weblionx/disaster-radio/hardware/board_v3/lora_nodemcu.kicad_pcb

## KiCad design hardware/board_v3/lora_nodemcu.kicad_pcb (2018-08-20)

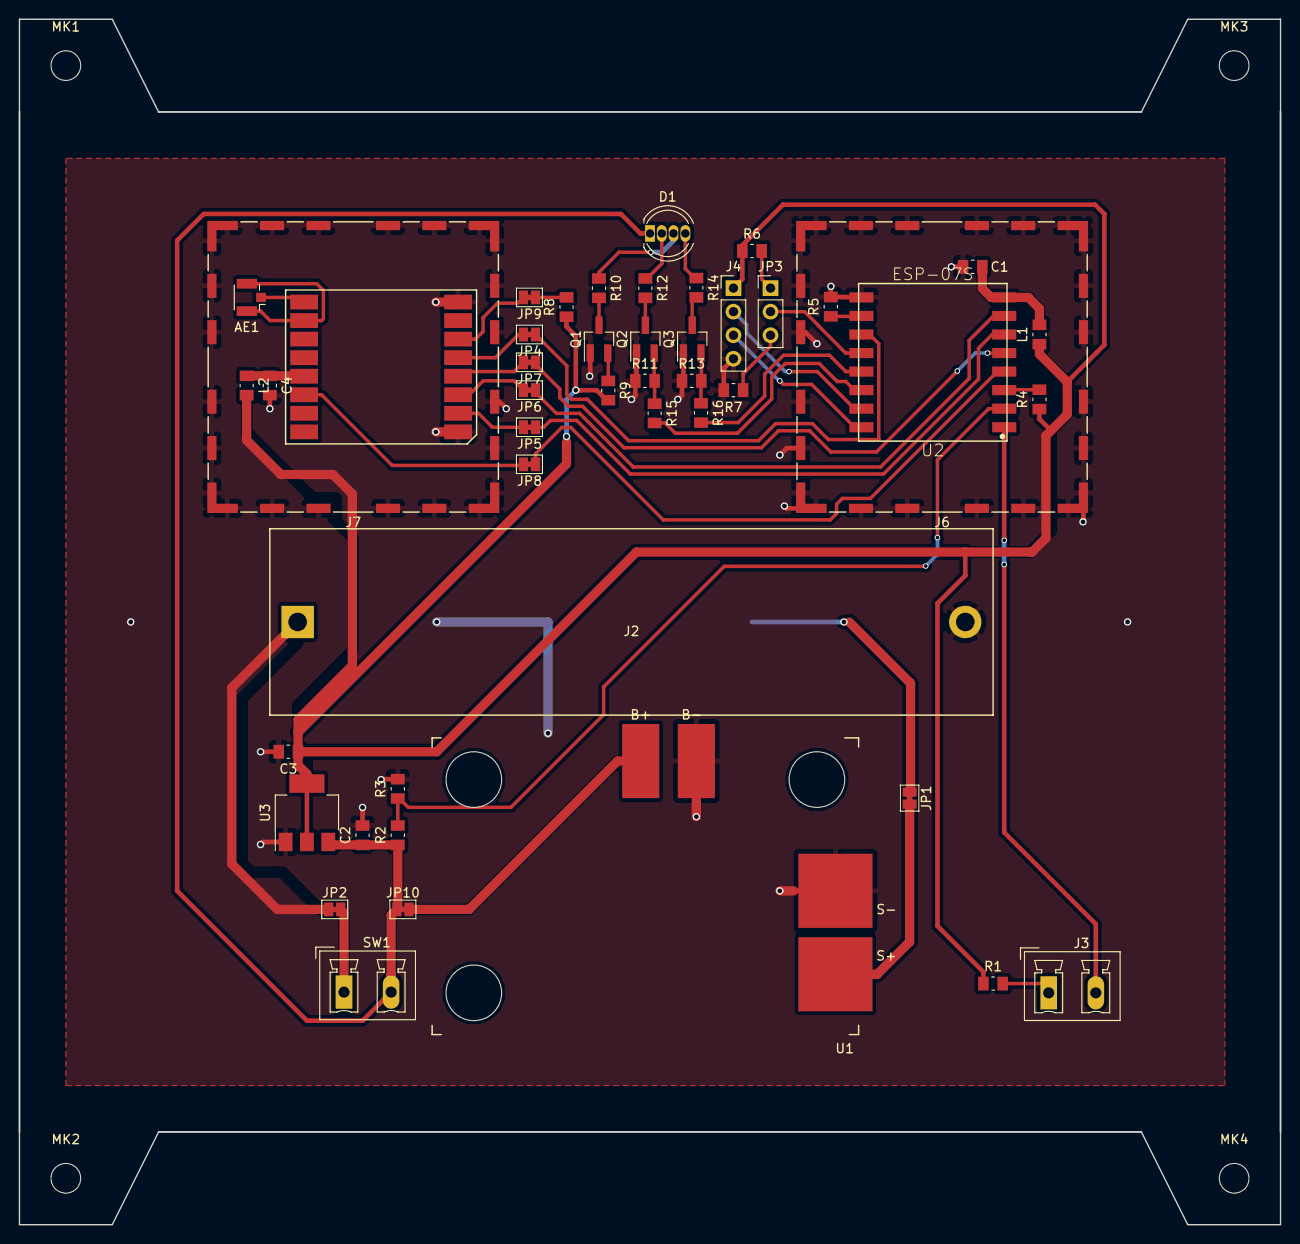
[picture p1: board lora_nodemcu.kicad_pcb from above]

Board: 2 copper layers, 136.0 x 130.0 mm, 52 parts (1 on the bottom side), 45 nets.

Parts:
AE1: RFM95_Antenna; U.FL_Hirose_U.FL-R-SMT-1_Vertical
C1, C4: 0.1uF; C_0805_2012Metric_Pad1.15x1.50mm_HandSolder
C2, C3: 10uF; C_0805_2012Metric_Pad1.15x1.50mm_HandSolder
D1: LED_ARGB; LED_D5.0mm-4
J1: Solar Panel; solar_panel_conn
J2: LiPo 18650; BatteryHolder_MPD_BH-18650-PC2
J3: RESET_BUTTON; PhoenixContact_MCV_1,5_2-G-5.08_1x02_P5.08mm_Vertical
J4: ESP_PRGM; PinHeader_1x04_P2.54mm_Vertical
J6: RF_Shield_ESP-07S; Wuerth_36103305_30x30mm
J7: RF_Shield_RFM95; Wuerth_36103305_30x30mm
JP1: SOLAR_TP; SolderJumper-2_P1.3mm_Bridged_Pad1.0x1.5mm
JP2: LiPo_TP; SolderJumper-2_P1.3mm_Bridged_Pad1.0x1.5mm
JP3: PRGM_SELECT; PinHeader_1x03_P2.54mm_Vertical
JP4: CS; SolderJumper-2_P1.3mm_Bridged_Pad1.0x1.5mm
JP5: MISO; SolderJumper-2_P1.3mm_Bridged_Pad1.0x1.5mm
JP6: MOSI; SolderJumper-2_P1.3mm_Bridged_Pad1.0x1.5mm
JP7: CLK; SolderJumper-2_P1.3mm_Bridged_Pad1.0x1.5mm
JP8: D1; SolderJumper-2_P1.3mm_Bridged_Pad1.0x1.5mm
JP9: RST; SolderJumper-2_P1.3mm_Bridged_Pad1.0x1.5mm
JP10: MPPT_TP; SolderJumper-2_P1.3mm_Bridged_Pad1.0x1.5mm
L1, L2: JUMPER; L_0805_2012Metric_Pad1.15x1.50mm_HandSolder
MK1, MK2, MK3, MK4: Mounting_Hole; MountingHole_3.2mm_M3
Q1, Q2, Q3: 2N3904; SOT-23_Handsoldering
R1, R3, R4, R5, R6, R7, R8, R9, R11, R13, R15, R16: 10K; R_0805_2012Metric_Pad1.15x1.50mm_HandSolder
R2: 47K; R_0805_2012Metric_Pad1.15x1.50mm_HandSolder
R10: 1K; R_0805_2012Metric_Pad1.15x1.50mm_HandSolder
R12: 470; R_0805_2012Metric_Pad1.15x1.50mm_HandSolder
R14: 330; R_0805_2012Metric_Pad1.15x1.50mm_HandSolder
SW1: SW_SPST; PhoenixContact_MCV_1,5_2-G-5.08_1x02_P5.08mm_Vertical
U1: CN3791_module
U2: ESP-07S
U3: LM1117-3.3; SOT-223-3_TabPin2
U4: RFM95

Connections:
+3V3: C3.1, J4.1, L1.1, L2.2, R1.1, R4.1, R6.1, R8.1, R9.2, U3.2
+BATT: C2.1, D1.1, JP10.1, R2.1, SW1.2, U3.3
/3V3_ESP: C1.1, L1.2, U2.8
/3V3_RFM: C4.1, L2.1, U4.13
/BATT_TP: JP10.2, U1.3
/BLUE: D1.4, R14.1
/GREEN: D1.3, R10.1
/LIPO_CONN: J2.1, JP2.1
/LIPO_TP: JP2.2, SW1.1
/RED: D1.2, R12.1
/SOLAR_CONN: J1.2, JP1.1
/SOLAR_TP: JP1.2, U1.1
/SPI_CLK: JP7.1, U2.5
/SPI_MISO: JP5.1, U2.6
/SPI_MOSI: JP6.1, U2.7
GND: C1.2, C2.2, C3.2, C4.2, J1.1, J2.2, J4.4, J6.1, J7.1, Q1.1, Q2.1, Q3.1, R3.2, R5.2, R7.2, R11.1, R13.1, U1.2, U1.4, U2.9, U3.1, U4.1, U4.8
unnamed: AE1.1, U4.9
unnamed: AE1.2, U4.10
unnamed: J3.1, R1.2
unnamed: J3.2, U2.1
unnamed: J4.2, U2.15
unnamed: J4.3, U2.16
unnamed: JP3.1, R6.2
unnamed: JP3.2, U2.12
unnamed: JP3.3, R7.1
unnamed: JP4.1, U2.11
unnamed: JP4.2, U4.5
unnamed: JP5.2, U4.2
unnamed: JP6.2, U4.3
unnamed: JP7.2, U4.4
unnamed: JP8.1, U2.4
unnamed: JP8.2, U4.14
unnamed: JP9.1, R8.2
unnamed: JP9.2, U4.6
unnamed: Q1.2, R9.1
unnamed: Q1.3, R10.2
unnamed: Q2.2, R11.2, R15.1
unnamed: Q2.3, R12.2
unnamed: Q3.2, R13.2, R16.1
unnamed: Q3.3, R14.2
unnamed: R2.2, R3.1, U2.2
unnamed: R4.2, U2.3
unnamed: R5.1, U2.10
unnamed: R15.2, U2.14
unnamed: R16.2, U2.13
